Layblar/layblar_pcb/kicad-libraries-main/3d/NCN5150DG.stp

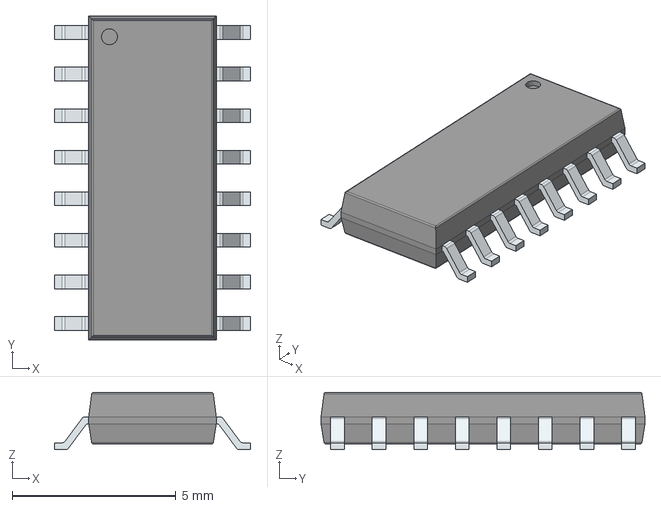
[picture p2: CAD file, 2023-11-26]
kicad-libraries-main/3d/NCN5150DG.stp
6.00 x 9.90 x 1.75 mm
PinsArrayLR
