Layblar/layblar_pcb/Layblar_PCB.kicad_pcb

## KiCad design Layblar_PCB.kicad_pcb (2024-02-08)

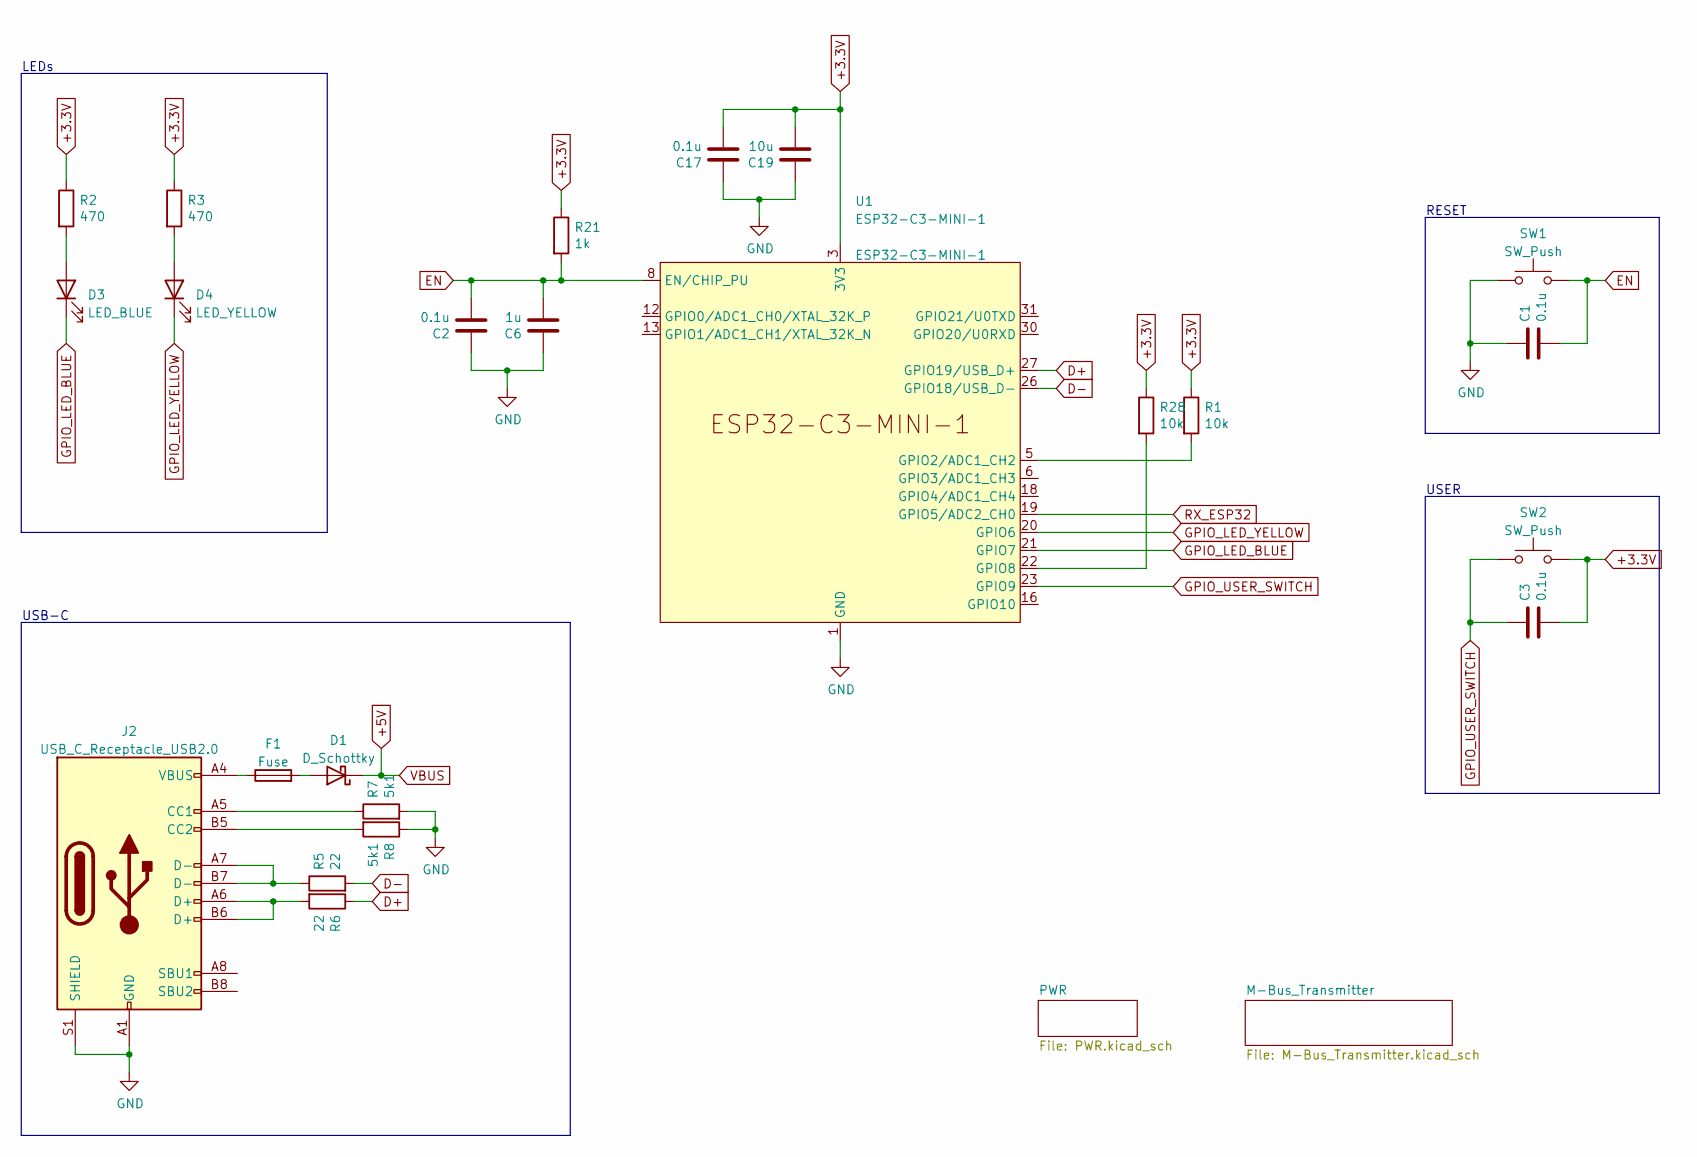
[picture p3: schematic Layblar_PCB.kicad_sch]

Parts:
C1, C2, C3, C17: 0.1u; C_0805_2012Metric
C6: 1u; C_0805_2012Metric
C19: 10u; C_0805_2012Metric
D1: D_Schottky; D_TUMD2
D3: LED_BLUE; LED_1206_3216Metric
D4: LED_YELLOW; LED_1206_3216Metric
F1: Fuse; Fuse_1812_4532Metric
J2: USB_C_Receptacle_USB2.0; USB_C_Receptacle_HRO_TYPE-C-31-M-12
R1, R28: 10k; R_0805_2012Metric
R2, R3: 470; R_0805_2012Metric
R5, R6: 22; R_0805_2012Metric
R7, R8: 5k1; R_0805_2012Metric
R21: 1k; R_0805_2012Metric
SW1, SW2: SW_Push; SW_Push_1P1T_NO_6x6mm_H9.5mm
U1: ESP32-C3-MINI-1

Connections:
+3.3V: C3.2, C17.2, C19.2, R1.1, R2.1, R3.1, R21.1, R28.1, SW2.2, U1.3 (3V3); also elsewhere on the board
+5V: D1.1 (K); also elsewhere on the board
D+: R6.1, U1.27 (GPIO19/USB_D+)
D-: R5.2, U1.26 (GPIO18/USB_D-)
EN: C1.2, C2.2, C6.2, R21.2, SW1.2, U1.8 (EN/CHIP_PU)
GND: C1.1, C2.1, C6.1, C17.1, C19.1, J2.A1 (GND), J2.A12 (GND), J2.B1 (GND), J2.B12 (GND), J2.S1 (SHIELD), R7.2, R8.1, SW1.1, U1.1 (GND), U1.2 (GND), U1.11 (GND), U1.14 (GND), U1.36 (GND), U1.37 (GND), U1.38 (GND), U1.39 (GND), U1.40 (GND), U1.41 (GND), U1.42 (GND), U1.43 (GND), U1.44 (GND), U1.45 (GND), U1.46 (GND), U1.47 (GND), U1.48 (GND), U1.49 (GND), U1.50 (GND), U1.51 (GND), U1.52 (GND), U1.53 (GND); also elsewhere on the board
GPIO_LED_BLUE: D3.1 (K), U1.21 (GPIO7)
GPIO_LED_YELLOW: D4.1 (K), U1.20 (GPIO6)
GPIO_USER_SWITCH: C3.1, SW2.1, U1.23 (GPIO9)
unnamed: D1.2 (A), F1.2
unnamed: D3.2 (A), R2.2
unnamed: D4.2 (A), R3.2
unnamed: F1.1, J2.A4 (VBUS), J2.A9 (VBUS), J2.B4 (VBUS), J2.B9 (VBUS)
unnamed: J2.A5 (CC1), R7.1
unnamed: J2.A6 (D+), J2.B6 (D+), R6.2
unnamed: J2.A7 (D-), J2.B7 (D-), R5.1
unnamed: J2.B5 (CC2), R8.2
unnamed: R1.2, U1.5 (GPIO2/ADC1_CH2)
unnamed: R28.2, U1.22 (GPIO8)
RX_ESP32: U1.19 (GPIO5/ADC2_CH0); also elsewhere on the board

Notes on the sheet:
USB-C
LEDs
USER
RESET

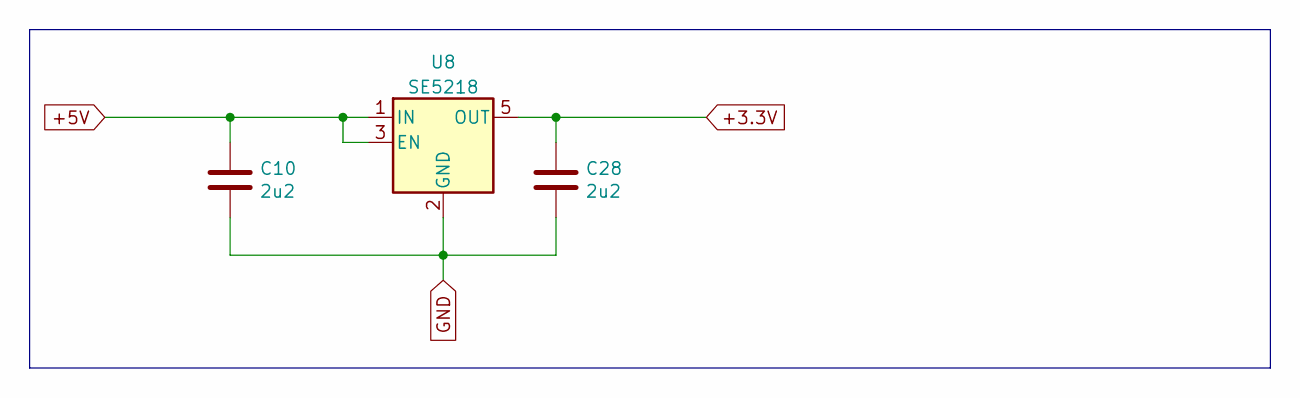
[picture p4: schematic PWR.kicad_sch]

Parts:
C10, C28: 2u2; C_0805_2012Metric
U8: SE5218; SOT-23-5

Connections:
+3.3V: C28.1, U8.5 (OUT); also elsewhere on the board
+5V: C10.1, U8.1 (IN), U8.3 (EN); also elsewhere on the board
GND: C10.2, C28.2, U8.2 (GND); also elsewhere on the board

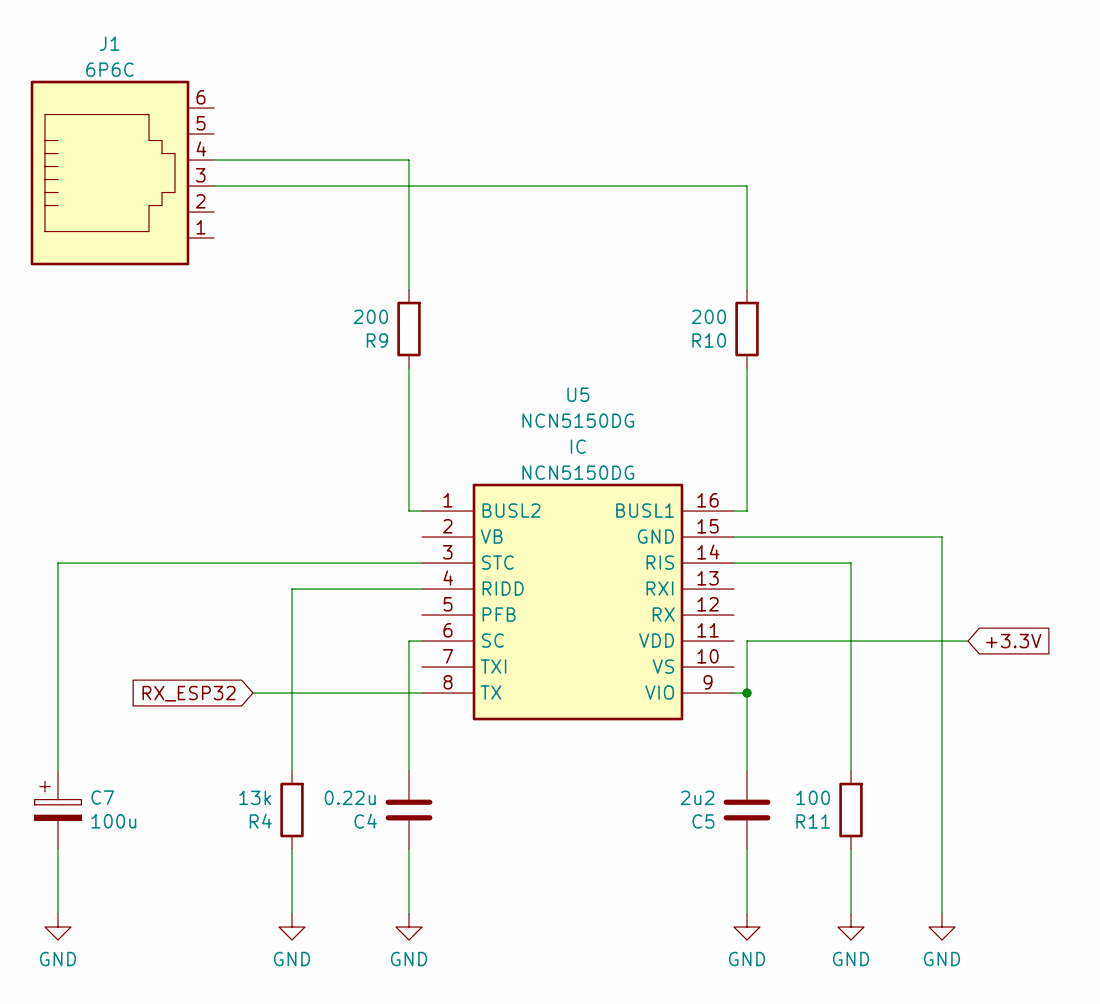
[picture p5: schematic M-Bus_Transmitter.kicad_sch]

Parts:
C4: 0.22u; C_0805_2012Metric
C5: 2u2; C_0805_2012Metric
C7: 100u; CP_Elec_6.3x7.7
J1: 6P6C; RJ12_Amphenol_54601
R4: 13k; R_0805_2012Metric
R9, R10: 200; R_0805_2012Metric
R11: 100; R_0805_2012Metric
U5: NCN5150DG; SOIC127P600X175-16N; Manufacturer_Part_Number NCN5150DG; Mouser Part Number 863-NCN5150DG

Connections:
+3.3V: C5.2, U5.9 (VIO); also elsewhere on the board
GND: C4.1, C5.1, C7.2, R4.1, R11.1, U5.15 (GND); also elsewhere on the board
unnamed: C4.2, U5.6 (SC)
unnamed: C7.1, U5.3 (STC)
unnamed: J1.3, R10.2
unnamed: J1.4, R9.2
unnamed: R4.2, U5.4 (RIDD)
unnamed: R9.1, U5.1 (BUSL2)
unnamed: R10.1, U5.16 (BUSL1)
unnamed: R11.2, U5.14 (RIS)
RX_ESP32: U5.8 (TX); also elsewhere on the board

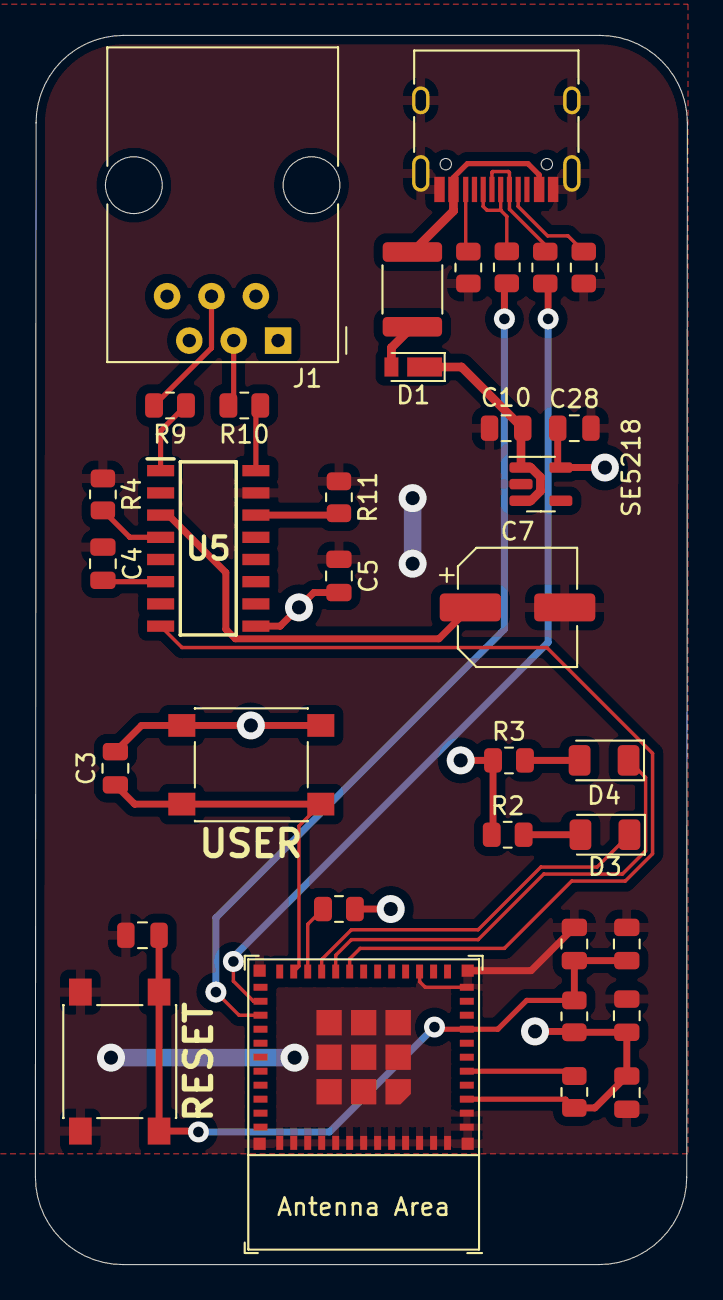
[picture p6: board Layblar_PCB.kicad_pcb from above]

Board: 4 copper layers, 37.3 x 70.3 mm, 35 parts (0 on the bottom side), 28 nets.
