Layblar/layblar_pcb/(commit log)

2024-01-18 Created Version 1.0
    Refactored board with tipps after coaching
    [Layblar_PCB-B_Cu.gbr, Layblar_PCB-B_Mask.gbr, Layblar_PCB-B_Paste.gbr, Layblar_PCB-B_Silkscreen.gbr, Layblar_PCB-Edge_Cuts.gbr, Layblar_PCB-F_Cu.gbr, Layblar_PCB-F_Mask.gbr, Layblar_PCB-F_Paste.gbr]
2024-01-24 Updated docs and fixed bug
    [Layblar_PCB-B_Cu.gbr, Layblar_PCB-B_Mask.gbr, Layblar_PCB-B_Paste.gbr, Layblar_PCB-B_Silkscreen.gbr, Layblar_PCB-Edge_Cuts.gbr, Layblar_PCB-F_Cu.gbr, Layblar_PCB-F_Mask.gbr, Layblar_PCB-F_Paste.gbr]
2024-02-08 Updated R4 Value and docs
    [Layblar_PCB-B_Cu.gbr, Layblar_PCB-B_Mask.gbr, Layblar_PCB-B_Paste.gbr, Layblar_PCB-B_Silkscreen.gbr, Layblar_PCB-Edge_Cuts.gbr, Layblar_PCB-F_Cu.gbr, Layblar_PCB-F_Mask.gbr, Layblar_PCB-F_Paste.gbr]
